craigyjp/16bit-8-note-MIDI-to-CV/block_diagram.jpg

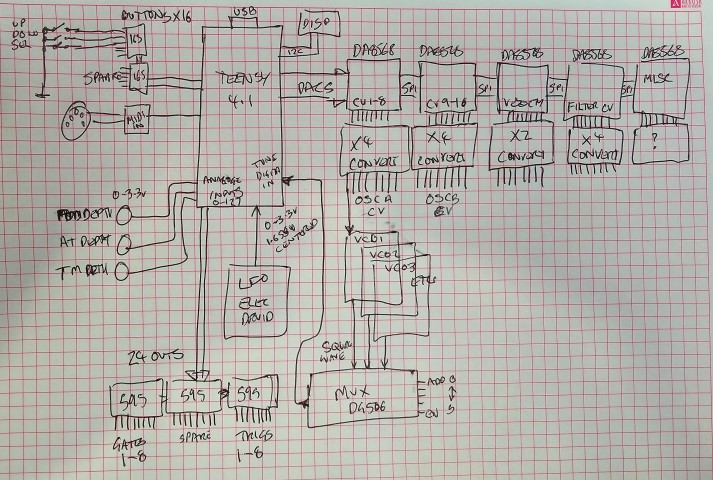
block_diagram.jpg
