craigyjp/16bit-8-note-MIDI-to-CV/Hardware/Add-ons/Autotune-Musings/attiny-freq-counter-schematic.pdf

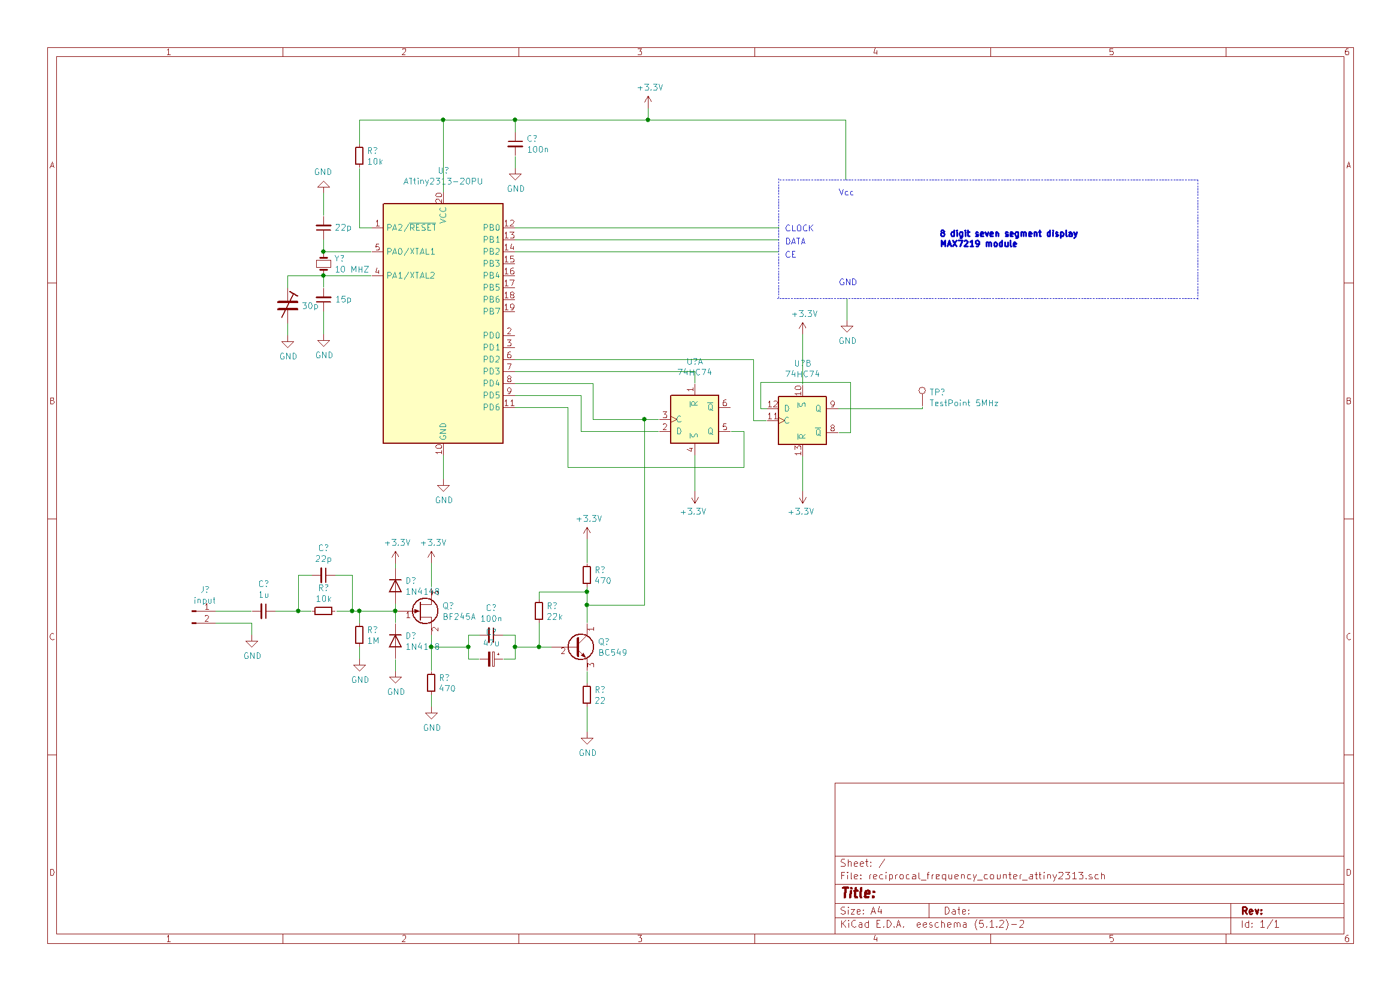
[picture p2: page 1]
