craigyjp/16bit-8-note-MIDI-to-CV/Hardware/Add-ons/Waveshaper/Amount_50pct.jpg

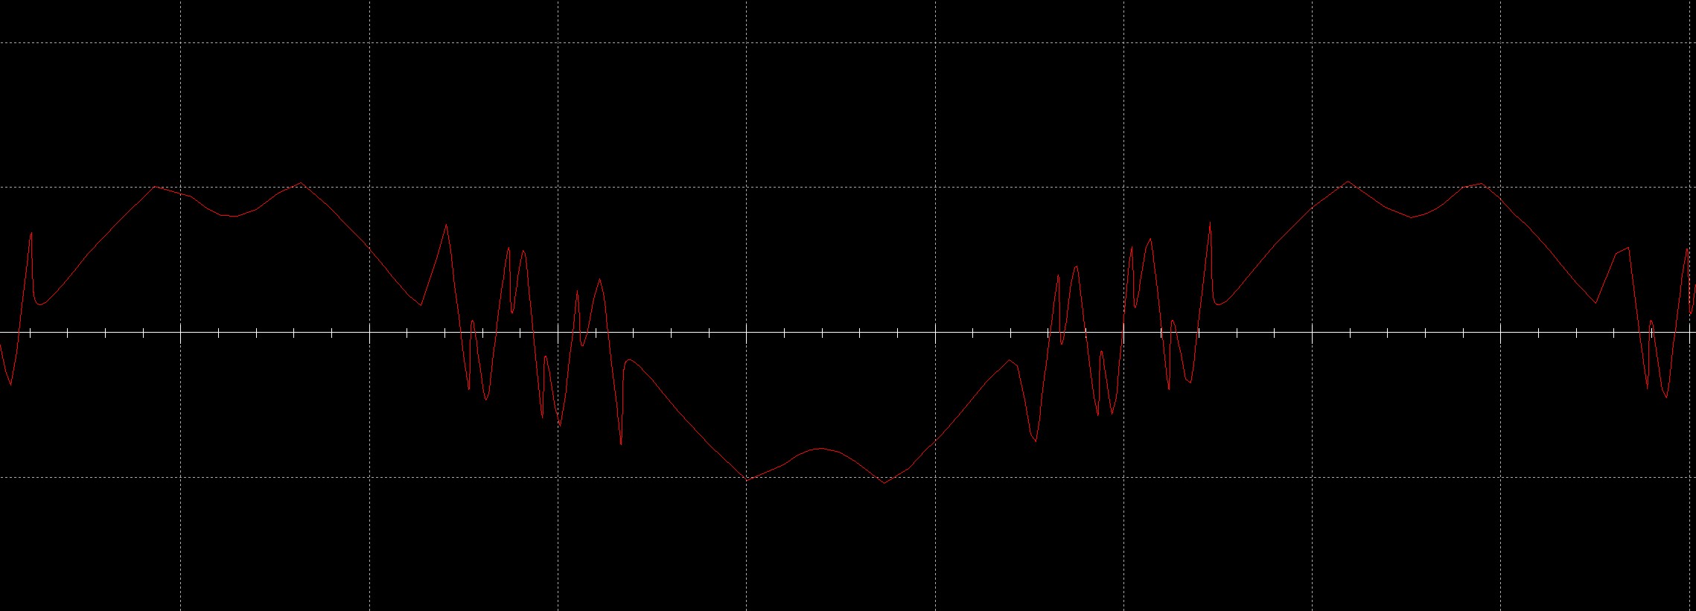
Hardware/Add-ons/Waveshaper/Amount_50pct.jpg
