craigyjp/16bit-8-note-MIDI-to-CV/Hardware/Add-ons/Waveshaper/Amount_100pct.jpg

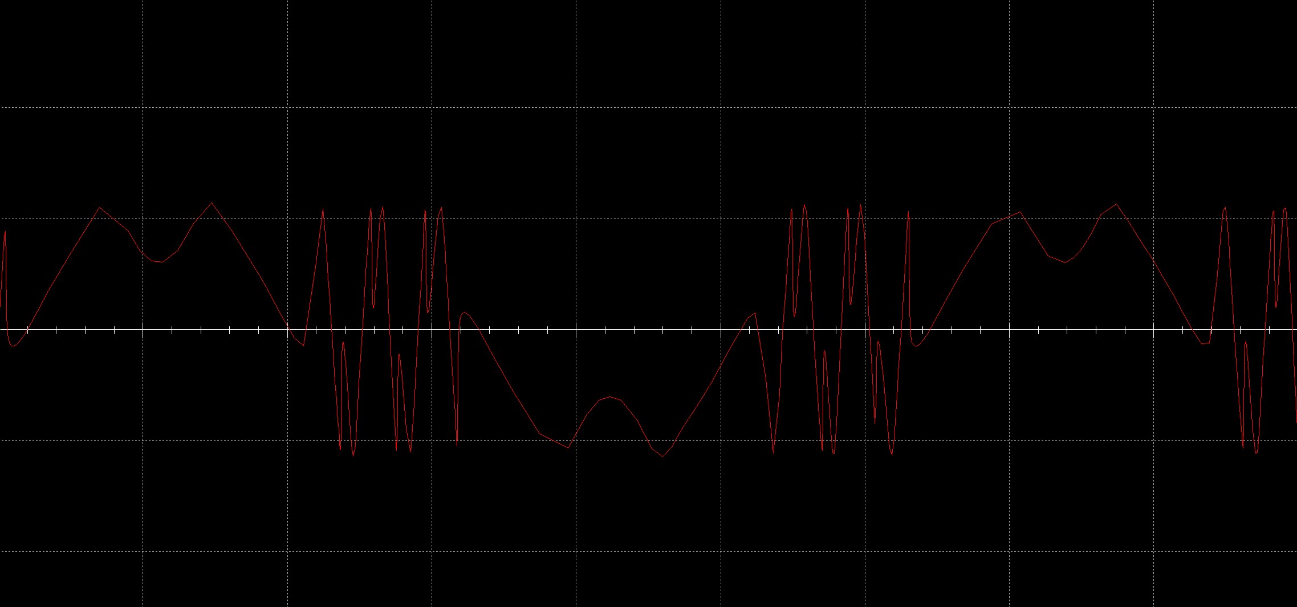
Hardware/Add-ons/Waveshaper/Amount_100pct.jpg
