craigyjp/16bit-8-note-MIDI-to-CV/(threads)

Thread 28 (2025-05-30):

Feature Request: MIDI Polyphonic Expression (MPE) support

syboxez, 2025-05-30:
**Is your feature request related to a problem? Please describe.**
N/A

**Describe the solution you'd like**
MIDI Polyphonic Expression (MPE) is an extremely useful feature in modern DAWs (and the occasional MIDI controller) that allows for individual notes to have pitch sliding, which can create some really cool sounds in a polysynth. Currently, no open source MIDI to CV projects support this feature.

**Describe alternatives you've considered**
Manual pitch sliding and recording one channel at a time, which is a pain and doesn't provide real time feedback.

**Additional context**
N/A
