craigyjp/16bit-8-note-MIDI-to-CV/Hardware/Add-ons/Autotune-Musings/VCO Maximus 3.5.pdf

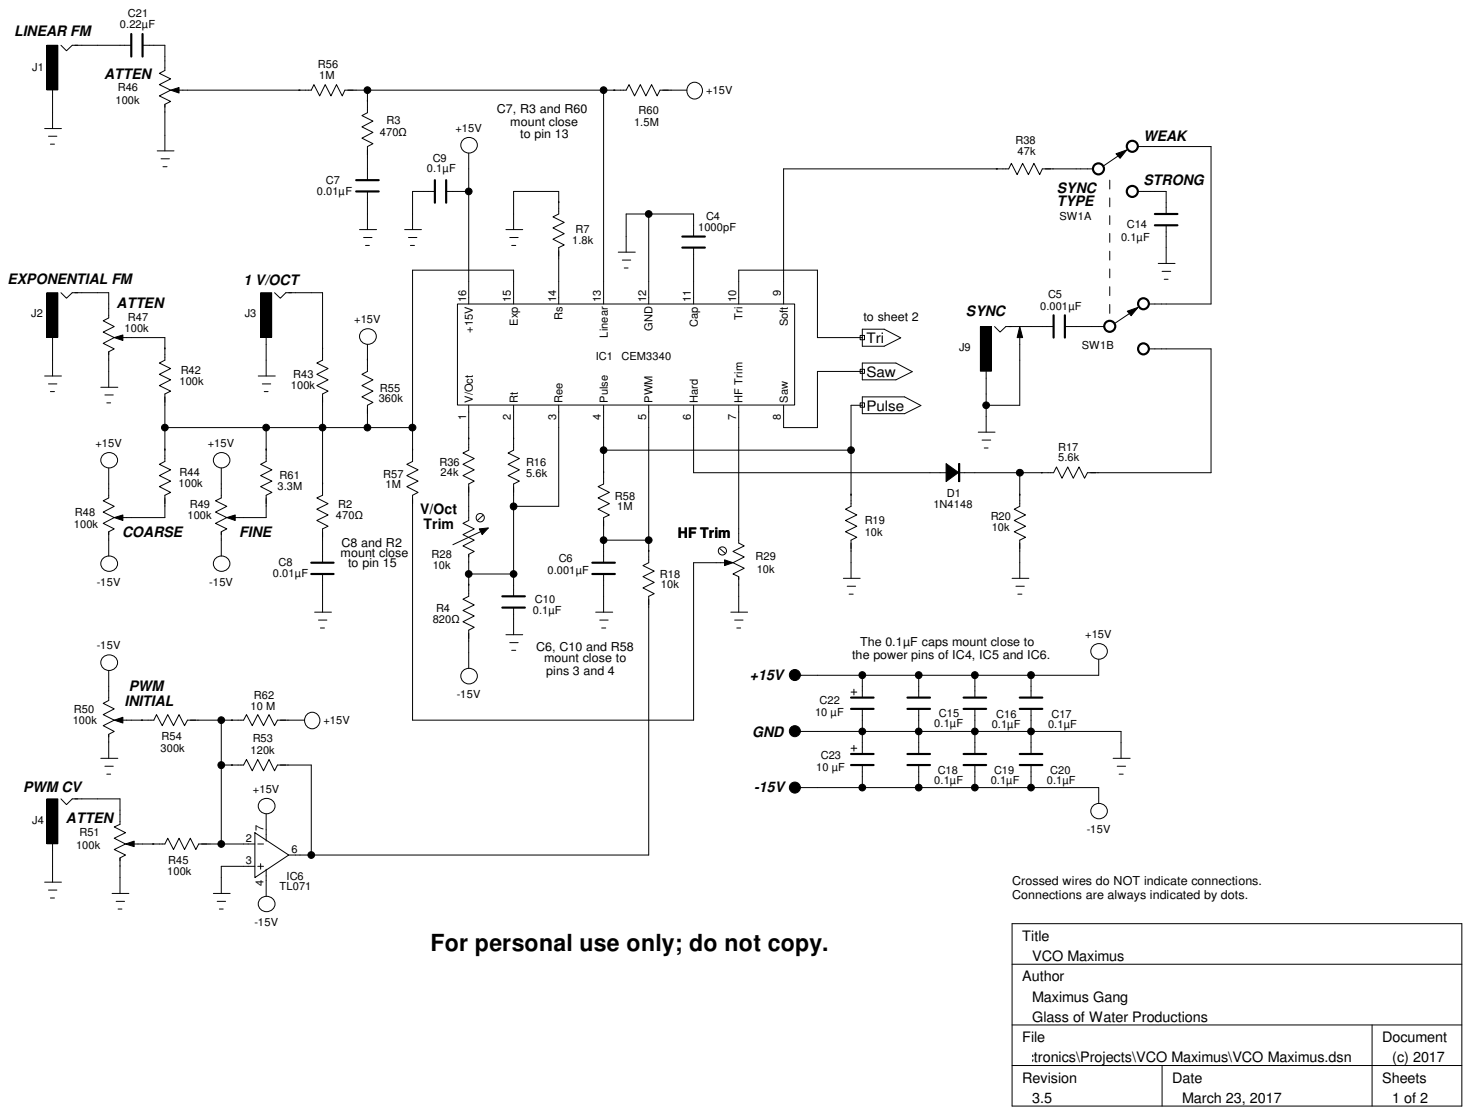
[picture p7: page 1]

The 0.1µF caps mount close to
the power pins of IC4, IC5 and IC6.

Crossed wires do NOT indicate connections.
Connections are always indicated by dots.

For personal use only; do not copy.

Title
VCO Maximus
Author
Maximus Gang
Glass of Water Productions

File | Document (c) 2017

ts\Electronics\Projects\VCO Maximus\VCO Maximus.dsn

Revision 3.5 | Date March 23, 2017 | Sheets 1 of 2

### Sine Round Trim

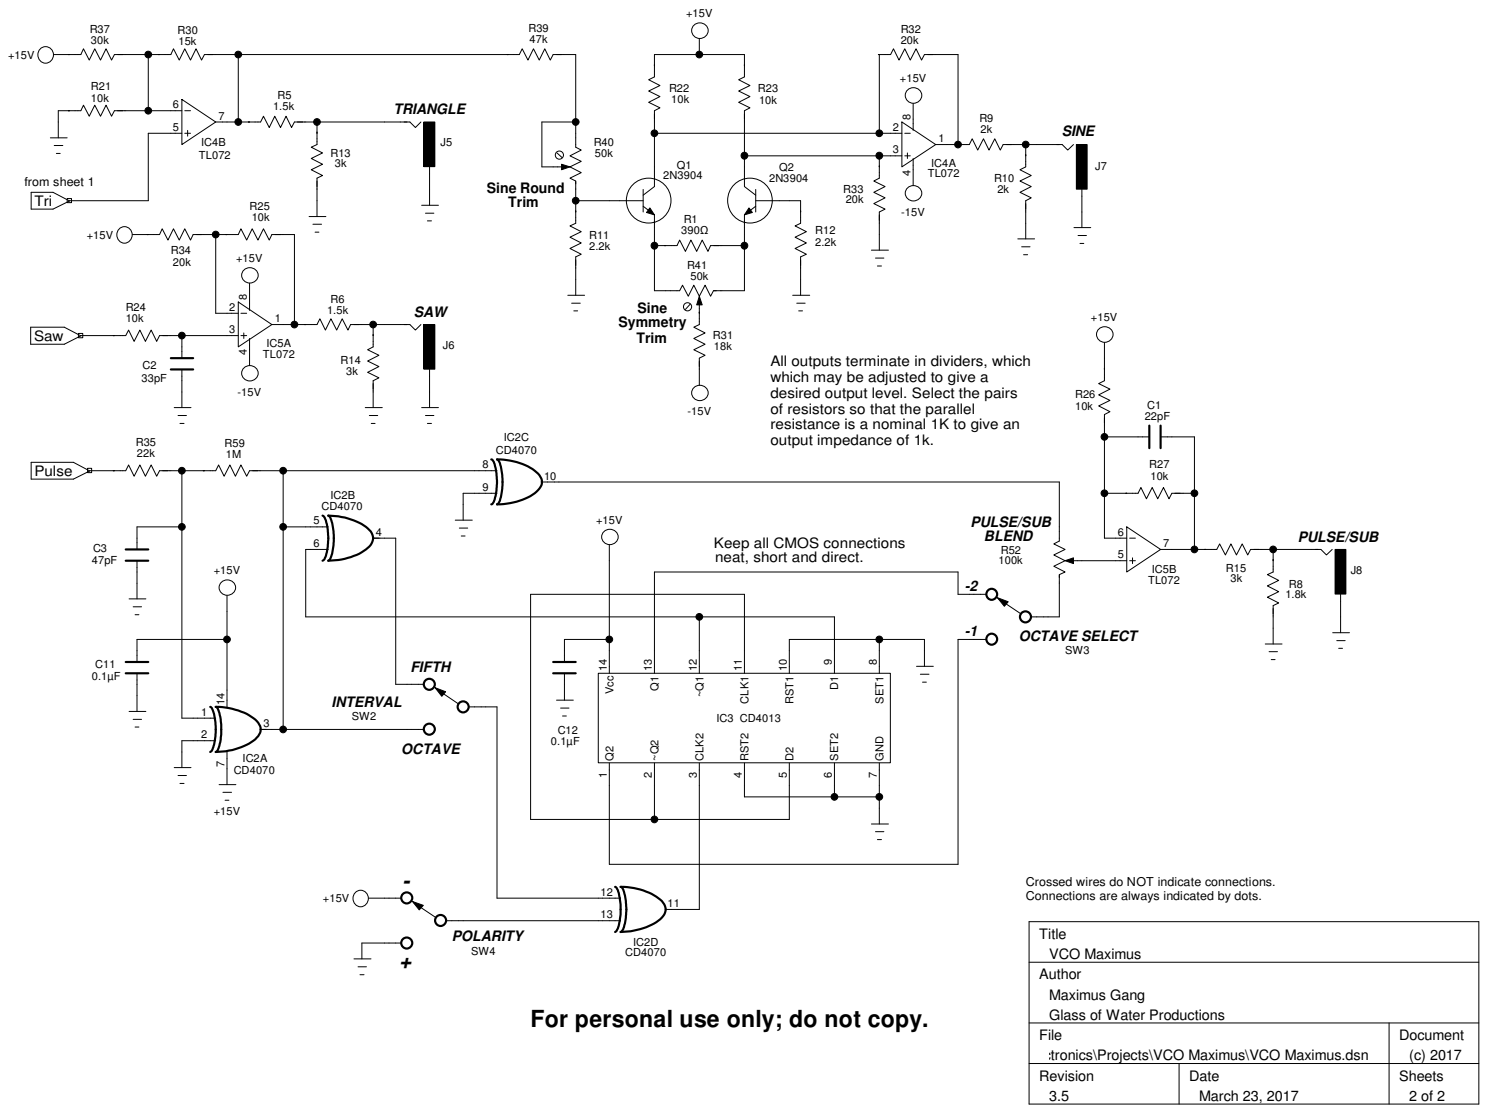
[picture p8: page 2]

All outputs terminate in dividers, which
which may be adjusted to give a
desired output level. Select the pairs
of resistors so that the parallel
resistance is a nominal 1K to give an
output impedance of 1k.

Keep all CMOS connections
neat, short and direct.

Crossed wires do NOT indicate connections.
Connections are always indicated by dots.

Title
VCO Maximus
Author
Maximus Gang
Glass of Water Productions

For personal use only; do not copy.

File | Document (c) 2017

ts\Electronics\Projects\VCO Maximus\VCO Maximus.dsn

Revision 3.5 | Date March 23, 2017 | Sheets 2 of 2
