craigyjp/16bit-8-note-MIDI-to-CV/Hardware/schematics/programmer.pdf

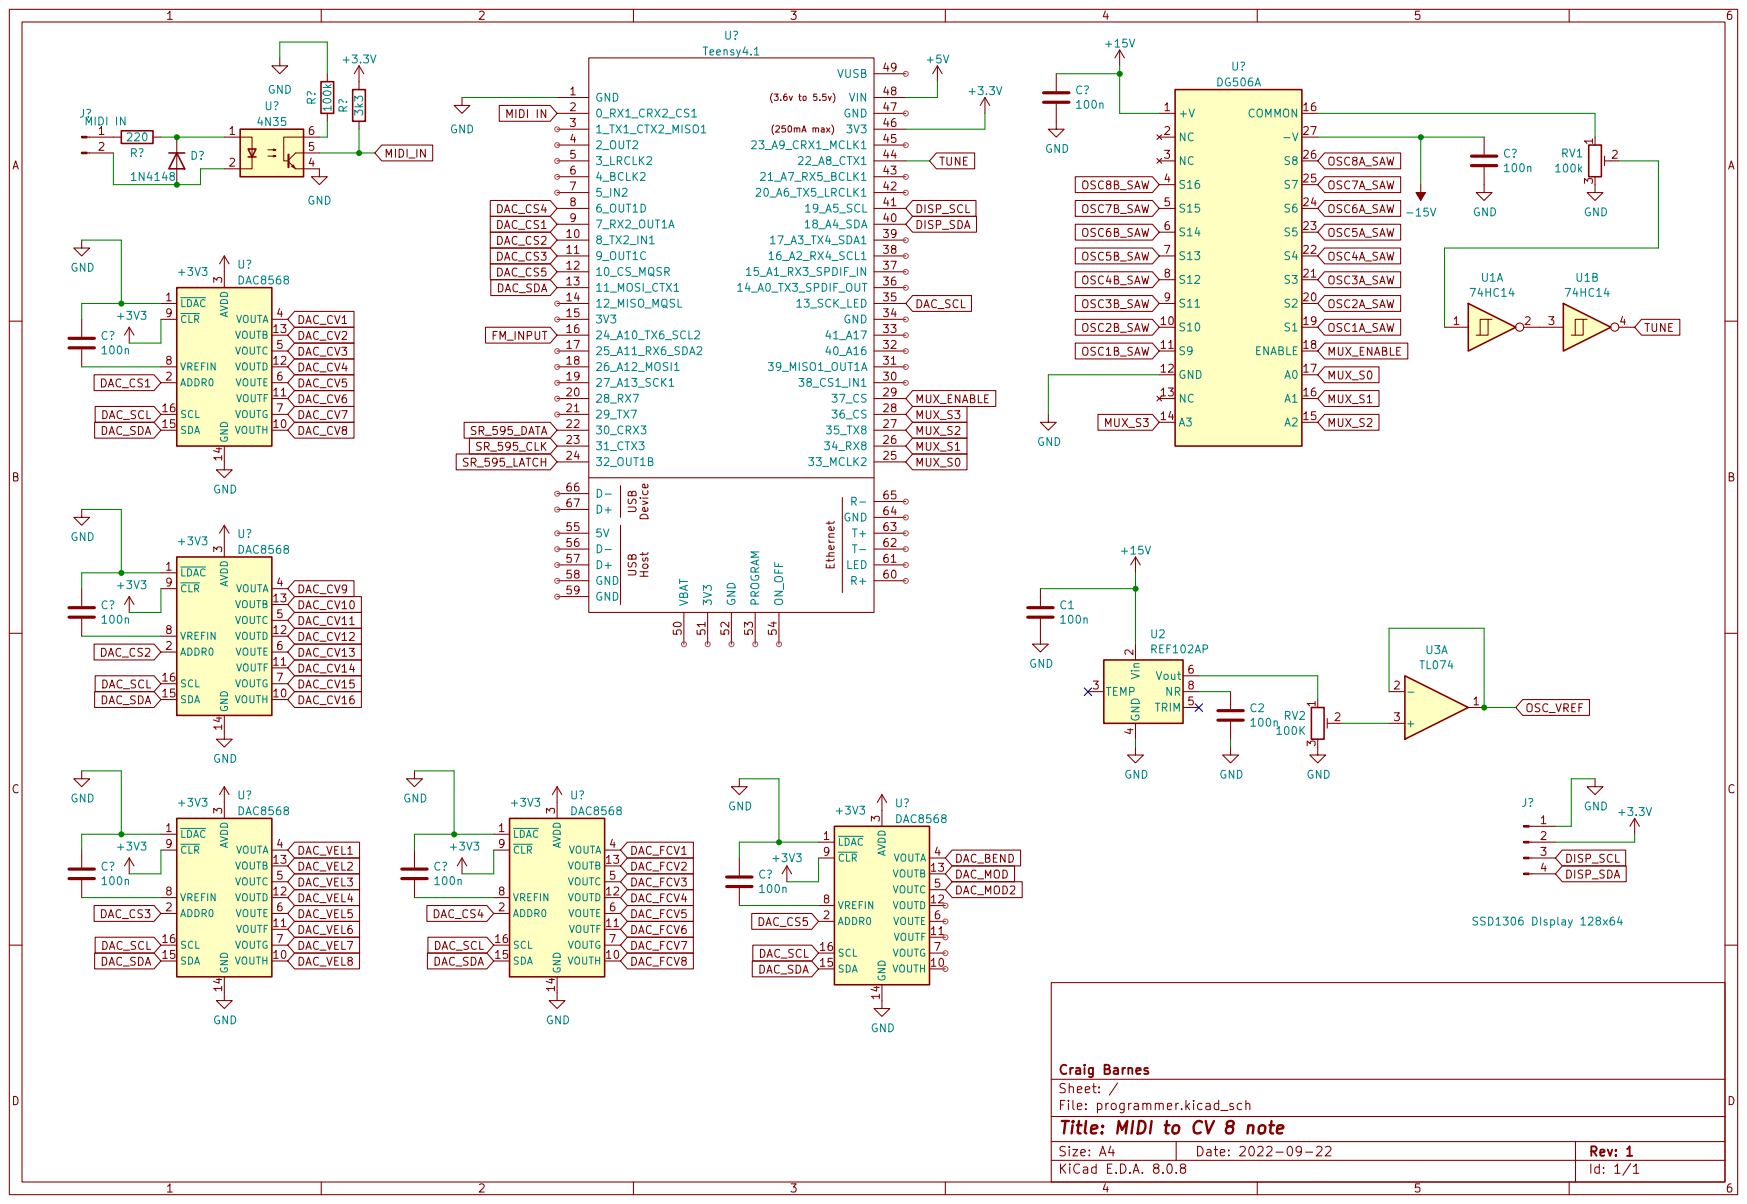
[picture p9: page 1]
