craigyjp/16bit-8-note-MIDI-to-CV/Hardware/schematics/gates_etc.pdf

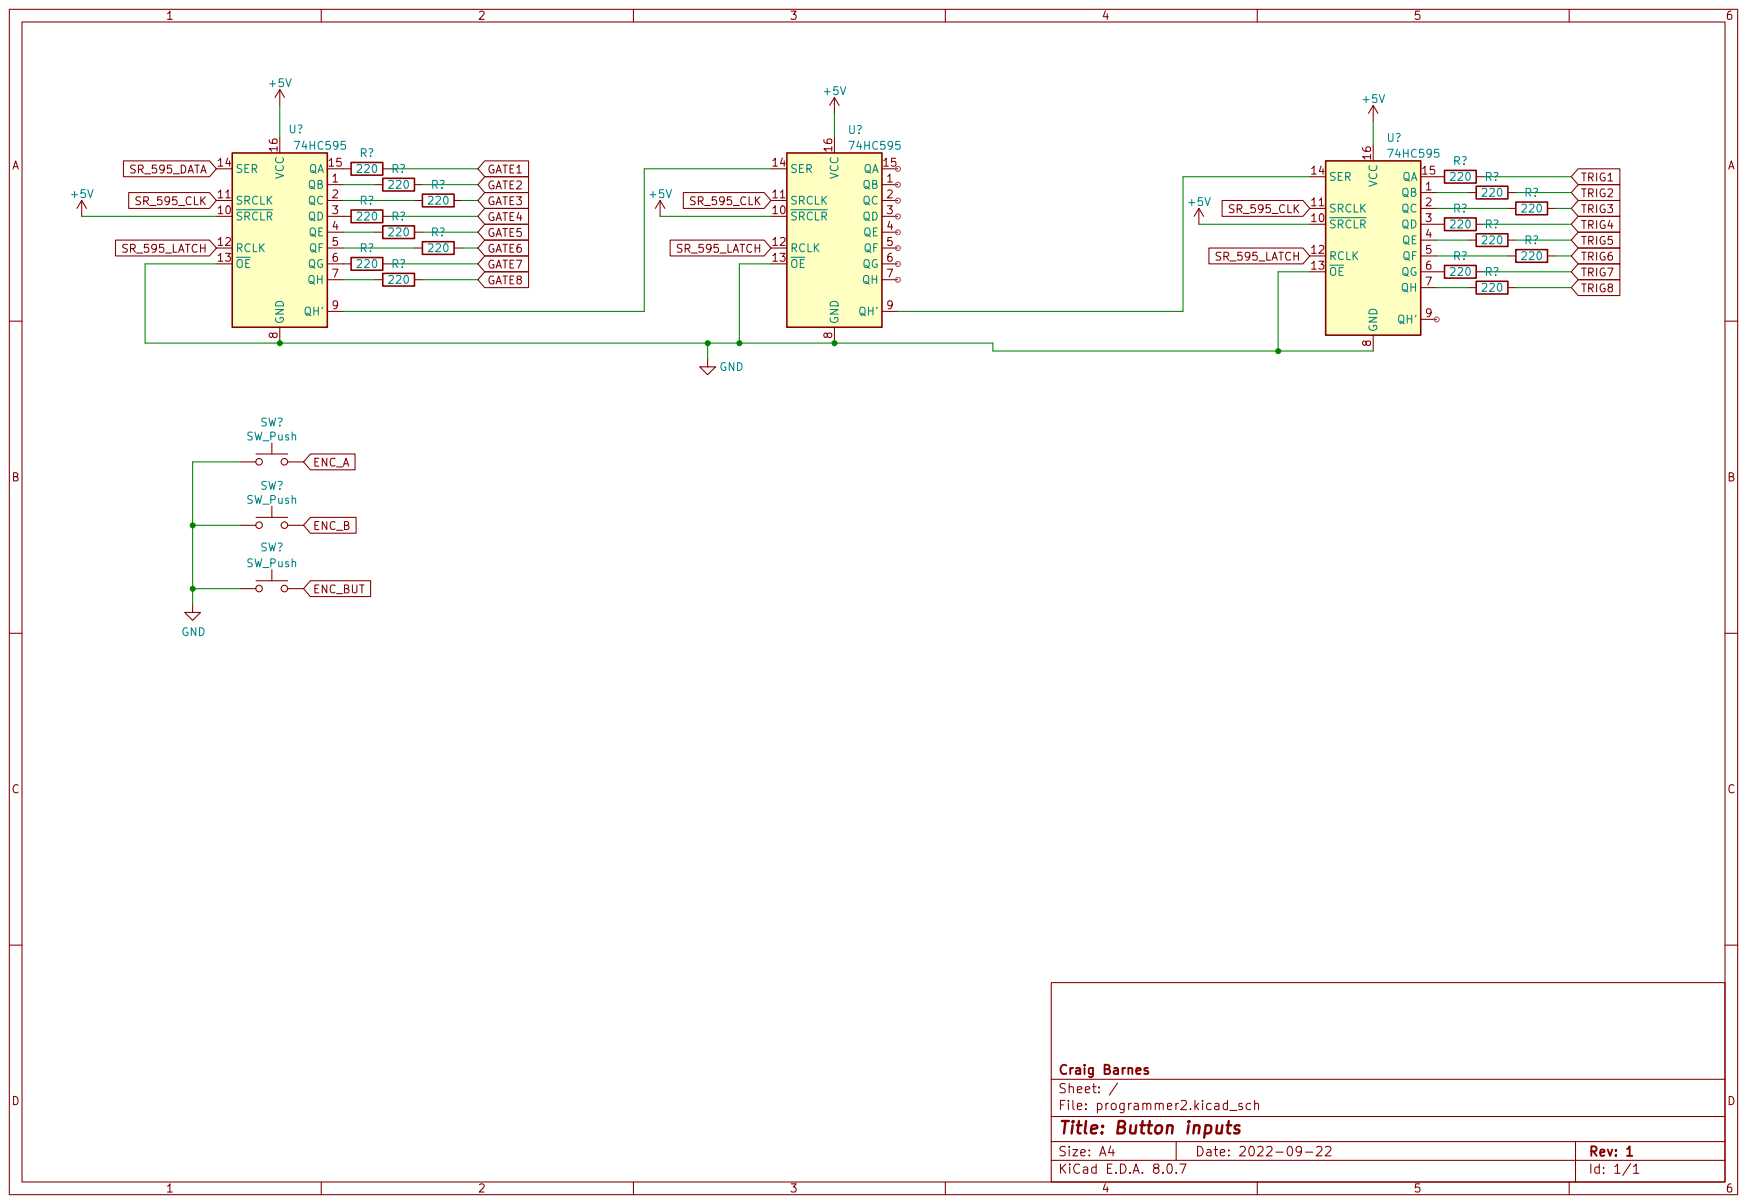
[picture p10: page 1]
