craigyjp/16bit-8-note-MIDI-to-CV/Hardware/schematics/level_converters.pdf

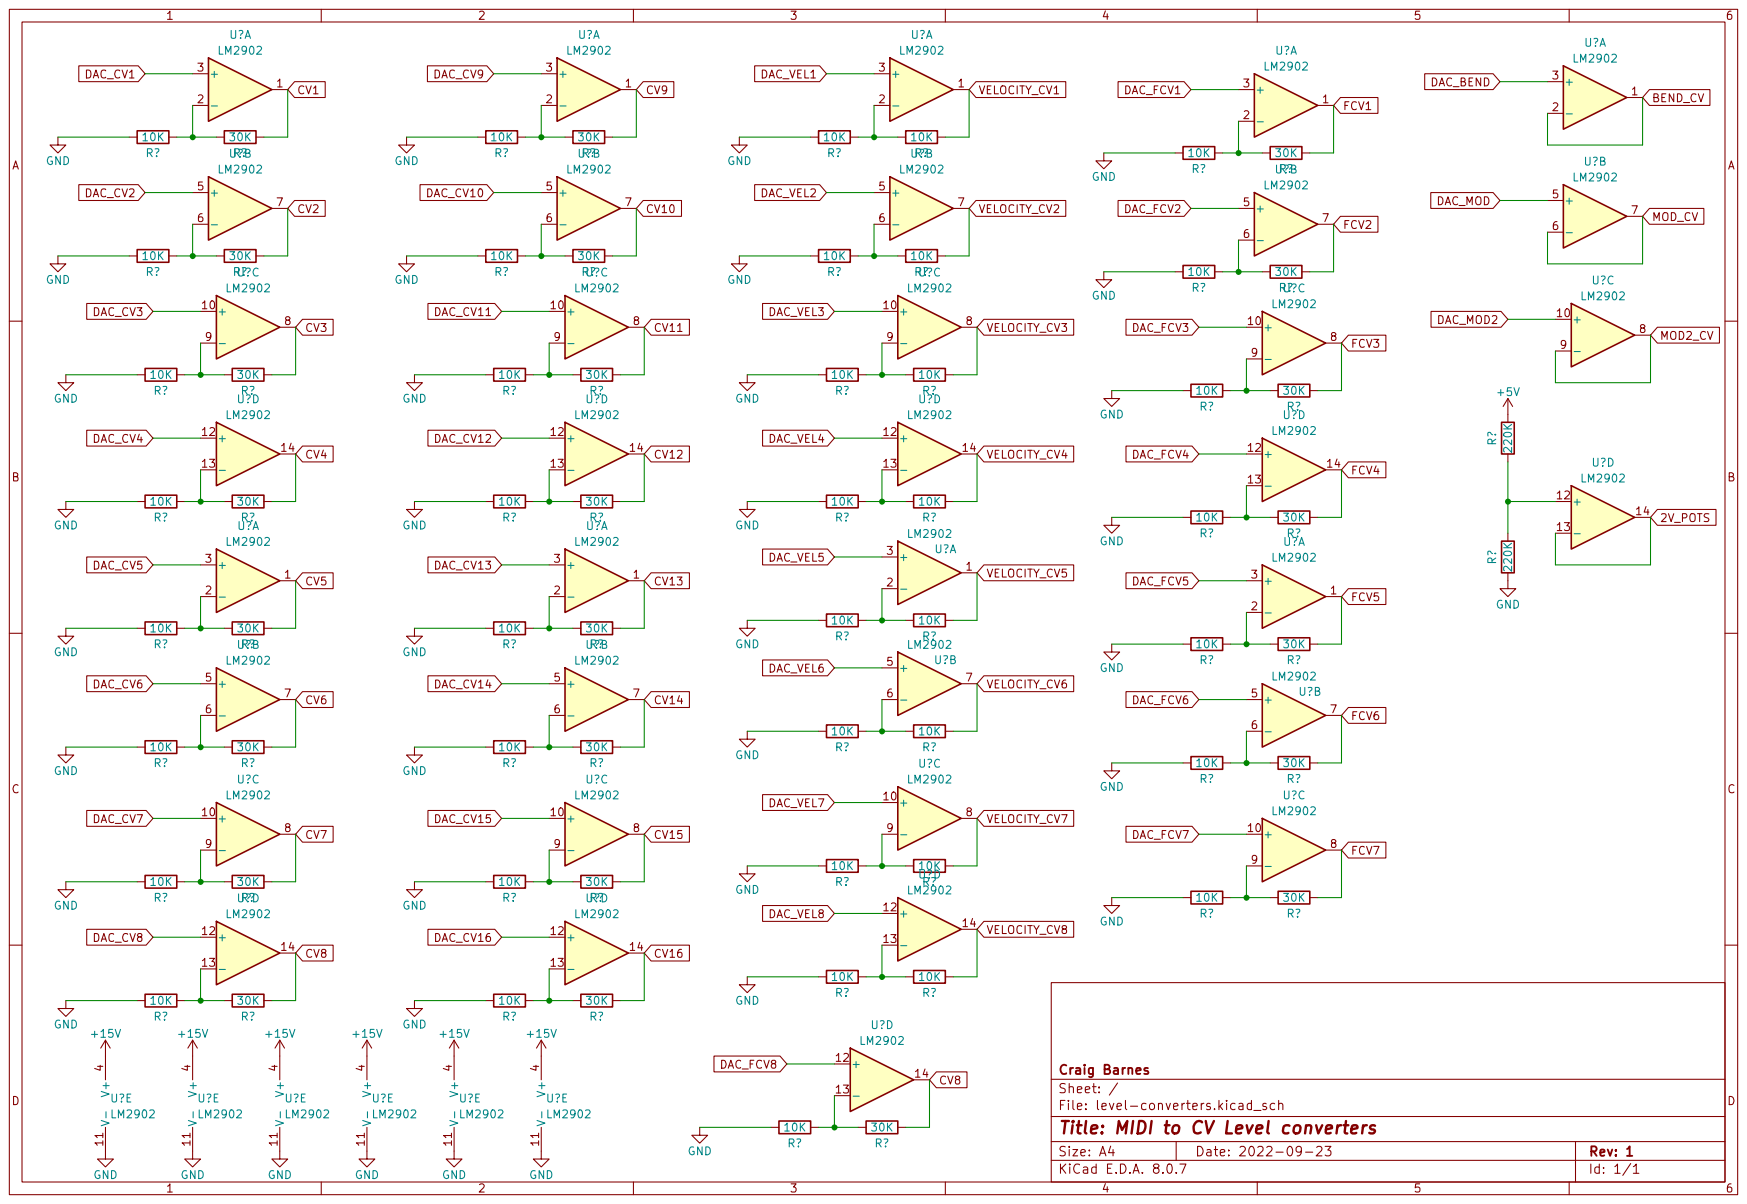
[picture p11: page 1]
