craigyjp/16bit-8-note-MIDI-to-CV/Hardware/schematics/LFO.pdf

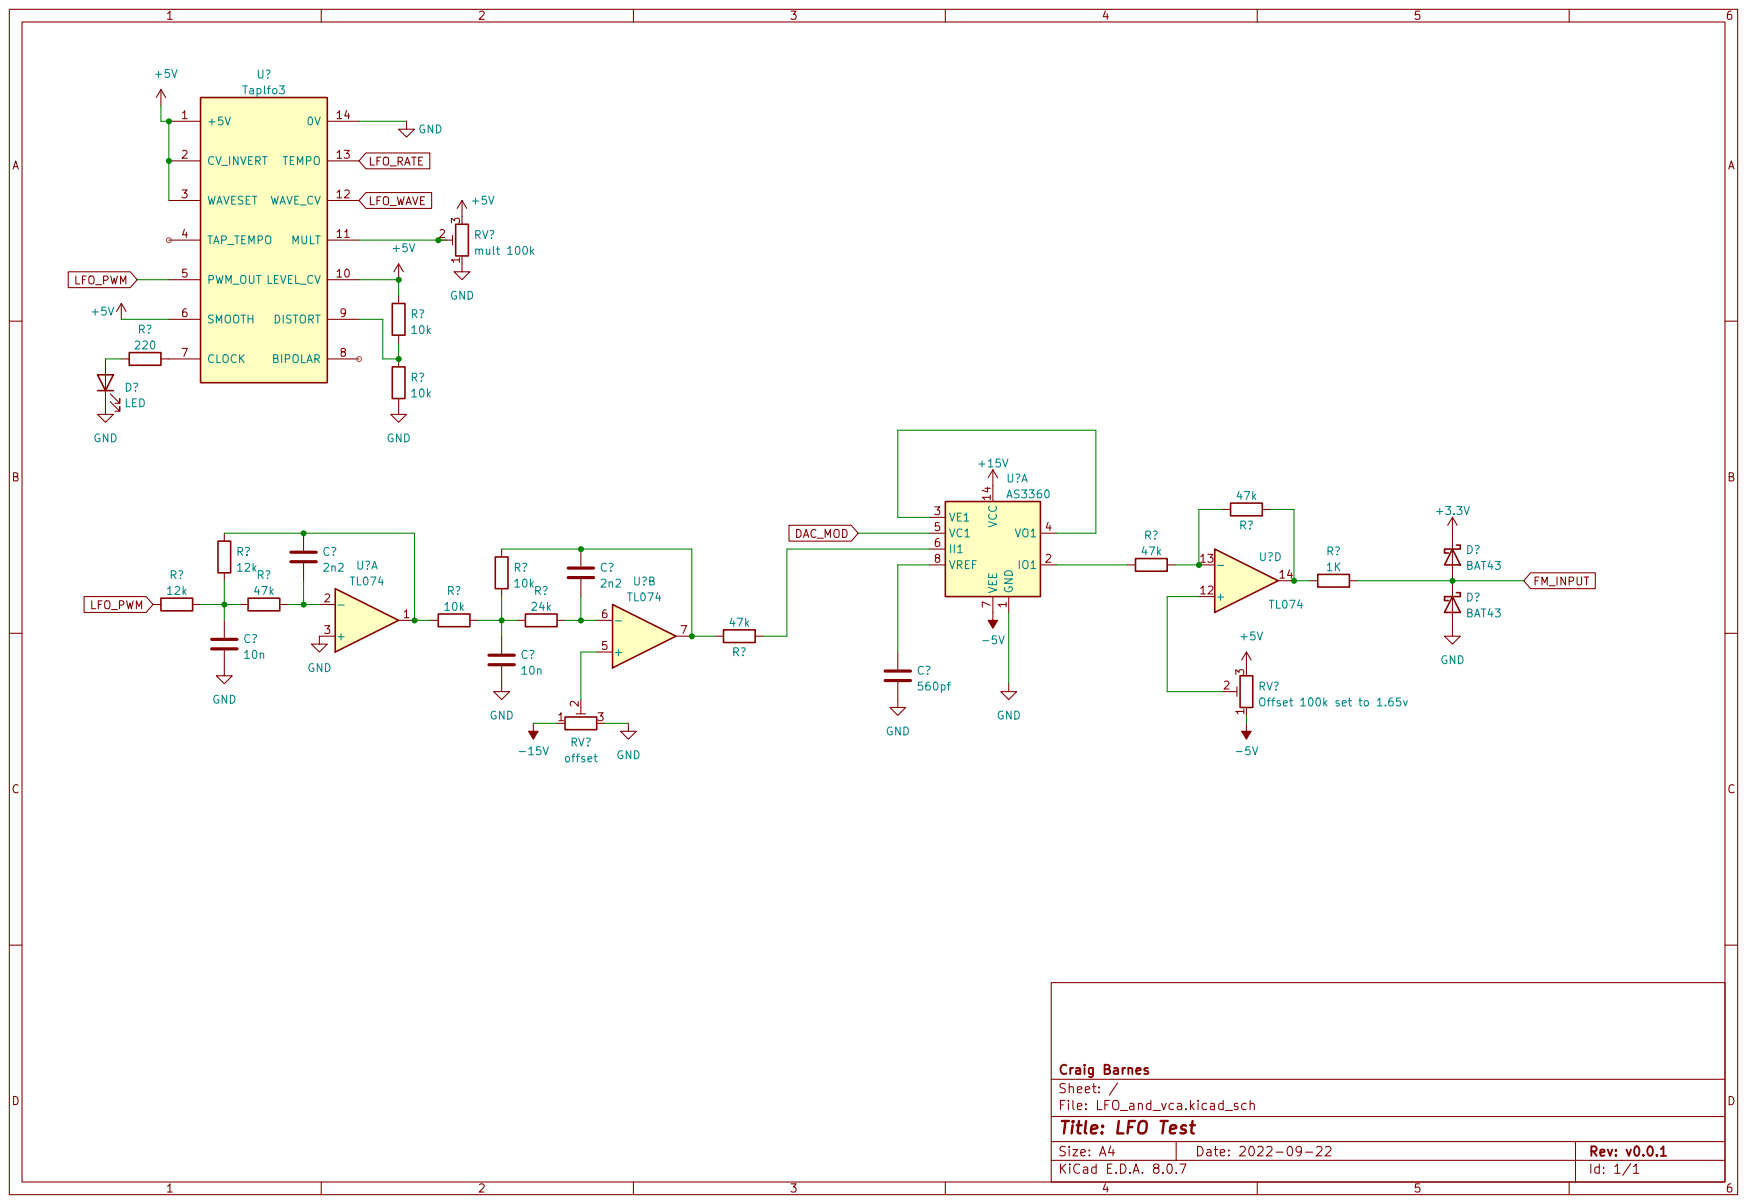
[picture p12: page 1]
