craigyjp/16bit-8-note-MIDI-to-CV/Hardware/schematics/Schematic_Polysynth voice board_2023-06-12.pdf

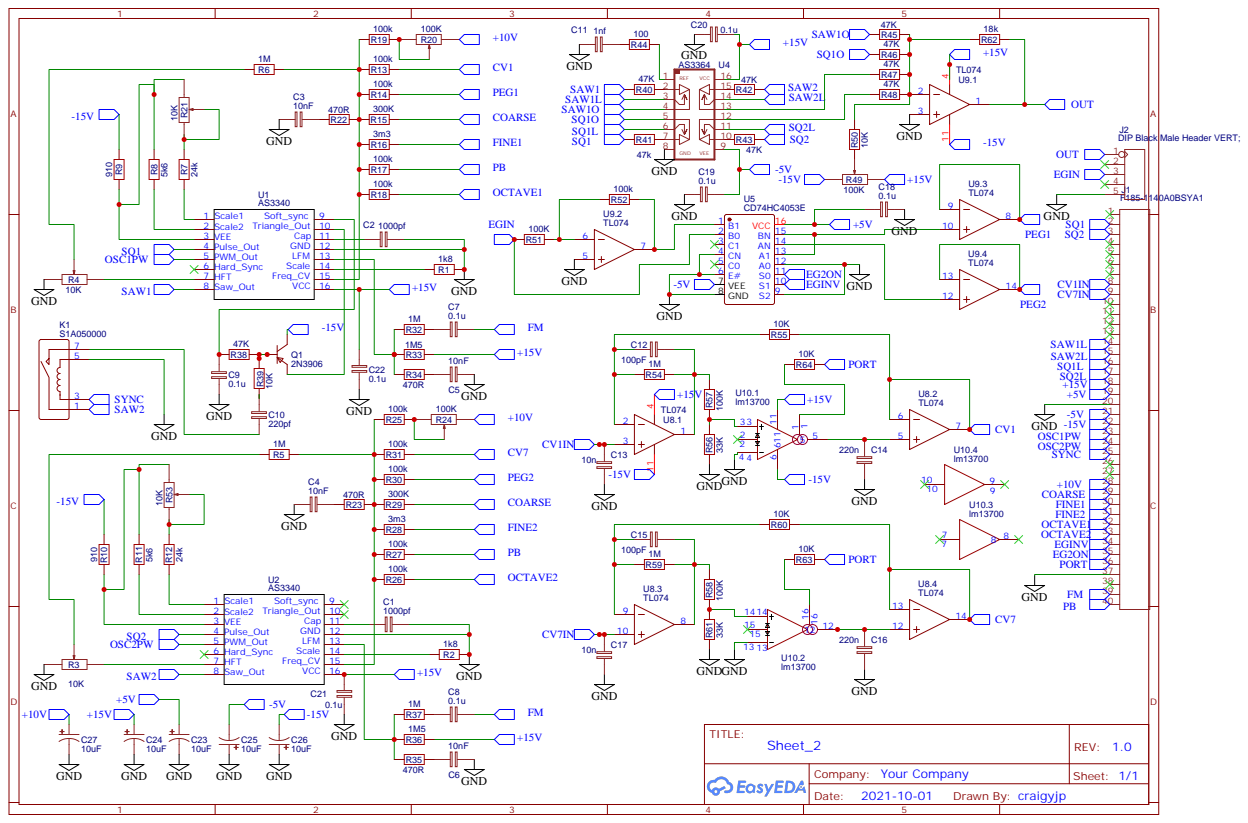
[picture p13: page 1]
