craigyjp/16bit-8-note-MIDI-to-CV/Hardware/Add-ons/Waveshaper/Serge6_Mod.pdf

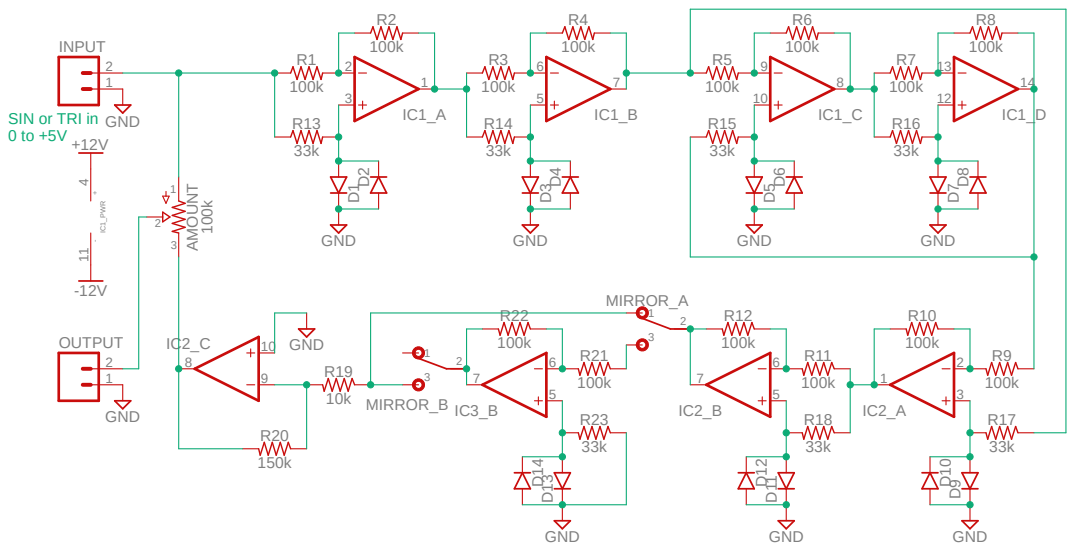
[picture p14: page 1]

SIN or TRI in
