craigyjp/16bit-8-note-MIDI-to-CV/(list of files, drawings)

Other design files:
Hardware/Waveshaper/Serge6_Mod.ms14
