craigyjp/16bit-8-note-MIDI-to-CV/code/Parameters.h

//
// Autotune
//            // Running total of the readings

#define A_NOTES_COUNT 8  // A0 (27.5 Hz), A1 (55 Hz), A2 (110 Hz), A3 (220 Hz), A4 (440 Hz), A5 (880 Hz), A6 (1760 Hz), A7 (3520 Hz)
const int A_NOTES[A_NOTES_COUNT] = {33, 45, 57, 69, 81, 93, 105, 117 };  // MIDI note numbers for A0 to A7

float midi_to_freqs[128][2] = {
  { 0, 4.09 },
  { 1, 4.33 },
  { 2, 4.59 },
  { 3, 4.86 },
  { 4, 5.15 },
  { 5, 5.45 },
  { 6, 5.78 },
  { 7, 6.12 },
  { 8, 6.49 },
  { 9, 6.87 },
  { 10, 7.28 },
  { 11, 7.71 },
  { 12, 8.17 },
  { 13, 8.66 },
  { 14, 9.17 },
  { 15, 9.72 },
  { 16, 10.30 },
  { 17, 10.91 },
  { 18, 11.56 },
  { 19, 12.25 },
  { 20, 12.98 },
  { 21, 13.75 },
  { 22, 14.57 },
  { 23, 15.43 },
  { 24, 16.35 },
  { 25, 17.32 },
  { 26, 18.35 },
  { 27, 19.45 },
  { 28, 20.60 },
  { 29, 21.83 },
  { 30, 23.12 },
  { 31, 24.50 },
  { 32, 25.96 },
  { 33, 27.50 },
  { 34, 29.14 },
  { 35, 30.87 },
  { 36, 32.7 },
  { 37, 34.65 },
  { 38, 36.71 },
  { 39, 38.89 },
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
};

int16_t autotune_value[128][16];

float frequency;        //storing frequency
boolean autotuneStart = false;
double measuredFrequency;
double measuredFreq;
elapsedMillis timeout;
int workingNote = 0;
const int numOscillators = 11;   // Number of oscillators - 1 as they start at 0
const int numNotes = 128;       // Number of MIDI notes
float targetFrequency = 0.00;
int tuneNote = 0;
byte note = 0;
int OCTAVE_A = 0;
int OCTAVE_B = 0;
int VOLTOFFSET = 3270;
int oscillator;
float currentFrequency[128];
int lastUsedVoice = 0; // Global variable to store the last used voice

//
// Modulation
//

float FM_VALUE = 0.0f;
float FM_AT_VALUE = 0.0f;
float TM_VALUE = 0.0f;
float TM_AT_VALUE = 0.0f;
float MOD_VALUE = 0.0f;

int FM_RANGE_UPPER = 0;
int FM_RANGE_LOWER = 0;
int FM_AT_RANGE_UPPER = 0;
int FM_AT_RANGE_LOWER = 0;

int TM_RANGE_UPPER = 0;
int TM_RANGE_LOWER = 0;
int TM_AT_RANGE_UPPER = 0;
int TM_AT_RANGE_LOWER = 0;

float FM_MOD_WHEEL = 0.00f;
float FM_AT_WHEEL = 0.00f;
float TM_AT_WHEEL = 0.00f;
float TM_MOD_WHEEL = 0.00f;

int BEND_WHEEL = 0;
int TM_RANGE = 0;
int DETUNE = 0;
int INTERVAL_POT = 0;
int INTERVAL = 0;

int encoderPos, encoderPosPrev;

int polyphony;
int masterChan;
int masterTran;
int previousMode;
int transpose;
int8_t d2, i;
int noteMsg;
int keyboardMode;
int octave;
int realoctave;
int bend_data;
int note1, note2, note3, note4, note5, note6, note7, note8;
int oscbnote1, oscbnote2, oscbnote3, oscbnote4, oscbnote5, oscbnote6, oscbnote7, oscbnote8;
int numPlayingVoices = 0;
bool sustainOn = false;
bool reset = false;
bool displayvalues = false;
bool osc1Through = false;
bool clearEEPROM = false;
byte sendnote, sendvelocity;

float oscillator1a = 1.000;
float oscillator2a = 1.000;
float oscillator3a = 1.000;
float oscillator4a = 1.000;
float oscillator5a = 1.000;
float oscillator6a = 1.000;
float oscillator7a = 1.000;
float oscillator8a = 1.000;
float oscillator1b = 1.000;
float oscillator2b = 1.000;
float oscillator3b = 1.000;
float oscillator4b = 1.000;
float oscillator5b = 1.000;
float oscillator6b = 1.000;
float oscillator7b = 1.000;
float oscillator8b = 1.000;

unsigned int velmV;
unsigned int mV;

float noteTrig[8];
float monoTrig;
float unisonTrig;

uint32_t int_ref_on_flexible_mode = 0b00001001000010100000000000000000;  // { 0000 , 1001 , 0000 , 1010000000000000 , 0000 }

uint32_t sample_data = 0b00000000000000000000000000000000;

uint32_t sample_data1 = 0b00000000000000000000000000000000;
uint32_t sample_data2 = 0b00000000000000000000000000000000;
uint32_t sample_data3 = 0b00000000000000000000000000000000;
uint32_t sample_data4 = 0b00000000000000000000000000000000;
uint32_t sample_data5 = 0b00000000000000000000000000000000;
uint32_t sample_data6 = 0b00000000000000000000000000000000;
uint32_t sample_data7 = 0b00000000000000000000000000000000;
uint32_t sample_data8 = 0b00000000000000000000000000000000;

uint32_t vel_data1 = 0b00000000000000000000000000000000;
uint32_t vel_data2 = 0b00000000000000000000000000000000;
uint32_t vel_data3 = 0b00000000000000000000000000000000;
uint32_t vel_data4 = 0b00000000000000000000000000000000;
uint32_t vel_data5 = 0b00000000000000000000000000000000;
uint32_t vel_data6 = 0b00000000000000000000000000000000;
uint32_t vel_data7 = 0b00000000000000000000000000000000;
uint32_t vel_data8 = 0b00000000000000000000000000000000;

uint32_t channel_a = 0b00000010000000000000000000000000;
uint32_t channel_b = 0b00000010000100000000000000000000;
uint32_t channel_c = 0b00000010001000000000000000000000;
uint32_t channel_d = 0b00000010001100000000000000000000;
uint32_t channel_e = 0b00000010010000000000000000000000;
uint32_t channel_f = 0b00000010010100000000000000000000;
uint32_t channel_g = 0b00000010011000000000000000000000;
uint32_t channel_h = 0b00000010011100000000000000000000;

// EEPROM Addresses
#define ADDR_GATE_TRIG 0  // (0-7)
#define ADDR_PITCH_BEND 8
#define ADDR_CC 9

#define ADDR_MASTER_CHAN 18
#define ADDR_TRANSPOSE 19
#define ADDR_REAL_TRANSPOSE 20
#define ADDR_OCTAVE 21
#define ADDR_REALOCTAVE 22
#define ADDR_KEYBOARD_MODE 23
#define ADDR_NOTE_NUMBER 30

bool highlightEnabled = false;   // Flag indicating whether highighting should be enabled on menu
#define HIGHLIGHT_TIMEOUT 20000  // Highlight disappears after 20 seconds.  Timer resets whenever encoder turned or button pushed
unsigned long int highlightTimer = 0;
