craigyjp/16bit-8-note-MIDI-to-CV/(commit log)

2023-06-06 Fixed timers on triggers, fixed keyboard modes
    [16bit_8_note_MIDI_CV_poly_autotune.ino]
2023-06-07 Updated SPI transfers, fixed v/octave ranges and pitch bend
    [16bit_8_note_MIDI_CV_poly_autotune.ino]
2023-06-10 Initial schematics
2023-06-11 Added code for filter CV and TM modulation
2023-06-11 Moved buttons to roxmux 16 channels of button inputs
2023-06-11 Added button mux
2023-06-11 Replaced 4504 converters with 74HC595 shift registers
    [16bit_8_note_MIDI_CV_poly_autotune.ino]
2023-06-12 Added code for mux inputs as supported by the schematics
2023-06-12 Fixed type on schematics
2023-06-12 Uploaded the test dual VCO board, not to be used in final design
2023-06-13 Added destination depths for Modwheel and Aftertouch to VCO or filter
2023-06-27 Updated code to tune all 16 oscillators
    [16bit_8_note_MIDI_CV_poly_autotune.ino, Parameters.h]
2023-06-28 Fixed bug in storing EEPROM values
    [16bit_8_note_MIDI_CV_poly_autotune.ino, Hardware.h, Parameters.h]
2023-06-28 Fixed bug in storing EEPROM values above VCO 2
    [16bit_8_note_MIDI_CV_poly_autotune.ino]
2023-06-28 Fixed a few bugs in the EEPROM
    [16bit_8_note_MIDI_CV_poly_autotune.ino, Hardware.h, Parameters.h]
2023-06-30 Create Freq-to-Volts
2023-06-30 Update and rename Hardware/Add-ons/Freq-to-Volts to Hardware/Add-ons/F2V/Freq-to-Volts.txt
2023-07-10 Create attiny-rewrite-precision-freq-counter.cpp
    Found this here: https://www.instructables.com/High-Resolution-Frequency-Counter/
    I let Chat-GPT recode this for Teensy 4.1. Should work with a resolution of 0.01 Hz in the range between 8 Hz and 10 kHz.
2024-06-06 Current working version
2025-01-21 Added voltage ref
